rodrigospimentacwb/lava_louca_110v_esp_32/caixa/desenhos/previa_base.png

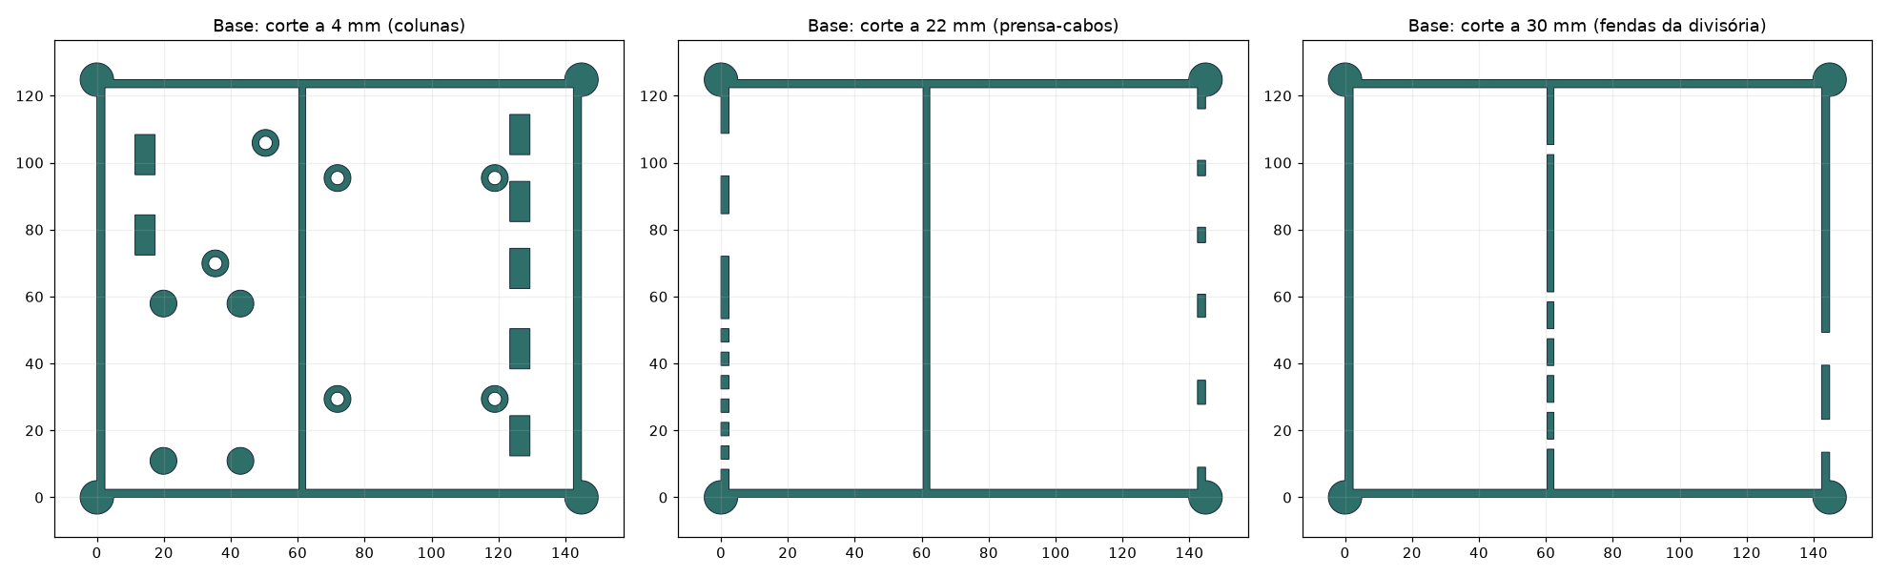
caixa/desenhos/previa_base.png
