rodrigospimentacwb/lava_louca_110v_esp_32/caixa/desenhos/previa_tampa.png

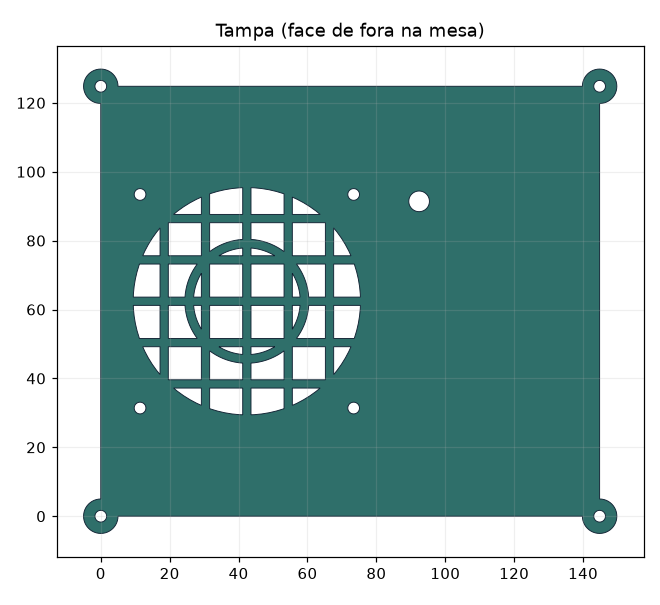
caixa/desenhos/previa_tampa.png
