rodrigospimentacwb/lava_louca_110v_esp_32/caixa/desenhos/render_tampa.png

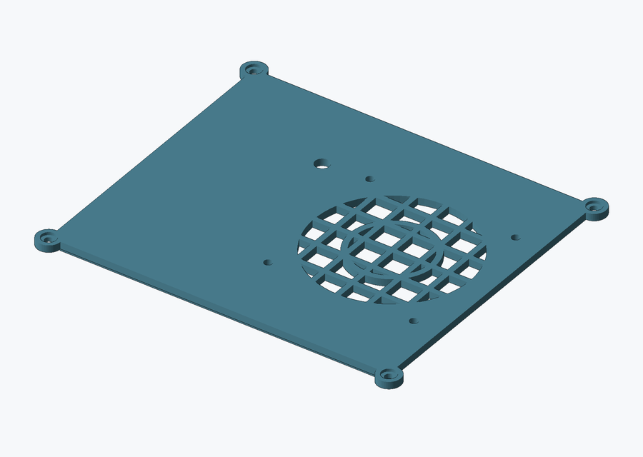
caixa/desenhos/render_tampa.png
