rodrigospimentacwb/lava_louca_110v_esp_32/caixa/desenhos/caixa_base.stl

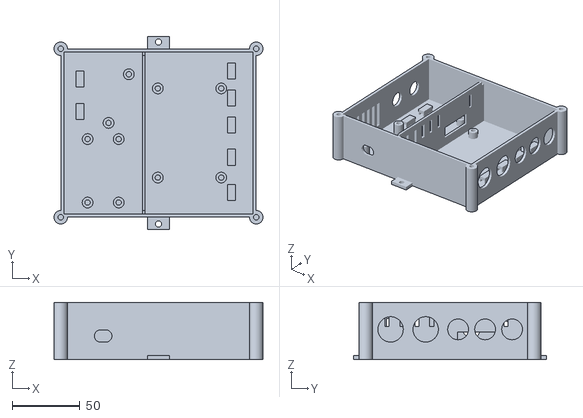
[picture p13: CAD file, 2026-10-19]
caixa/desenhos/caixa_base.stl
154.8 x 142.8 x 42.4
