rodrigospimentacwb/lava_louca_110v_esp_32/caixa/desenhos/caixa_bambu.3mf

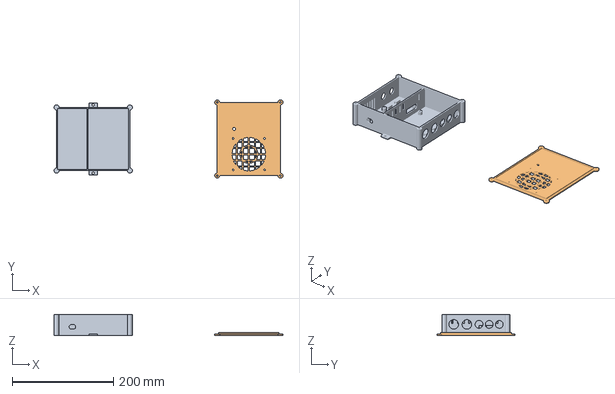
[picture p14: CAD file, 2026-10-19]
caixa/desenhos/caixa_bambu.3mf
452.0 x 154.8 x 42.4 mm
base
tampa
