rodrigospimentacwb/lava_louca_110v_esp_32/caixa/desenhos/caixa_lava_loucas.3mf

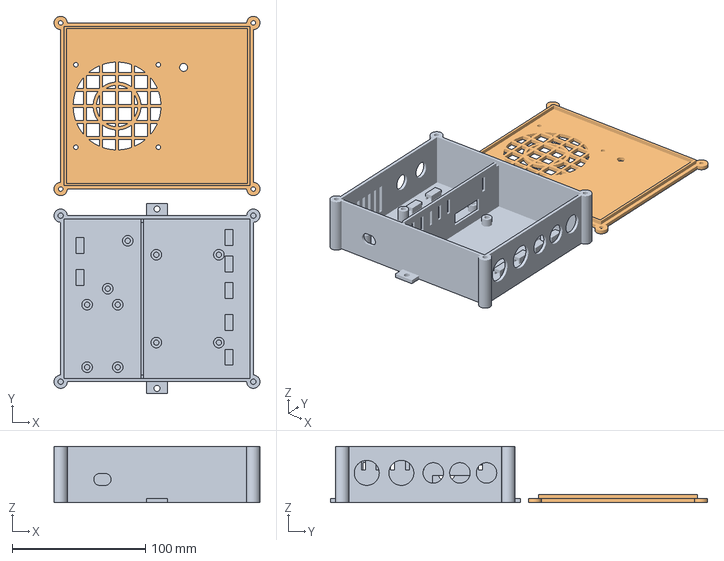
[picture p15: CAD file, 2026-10-19]
caixa/desenhos/caixa_lava_loucas.3mf
154.8 x 283.6 x 42.4 mm
base
tampa
