rodrigospimentacwb/lava_louca_110v_esp_32/caixa/desenhos/gabarito_reles.stl

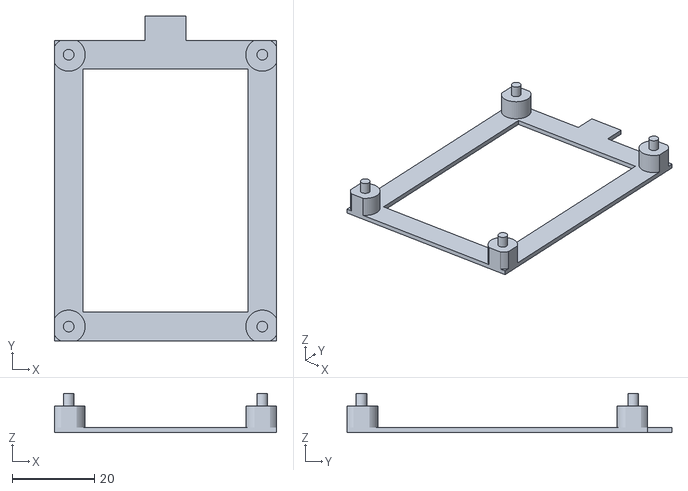
[picture p16: CAD file, 2026-10-19]
caixa/desenhos/gabarito_reles.stl
54.0 x 78.9 x 9.50
