rodrigospimentacwb/lava_louca_110v_esp_32/caixa/desenhos/gabaritos.3mf

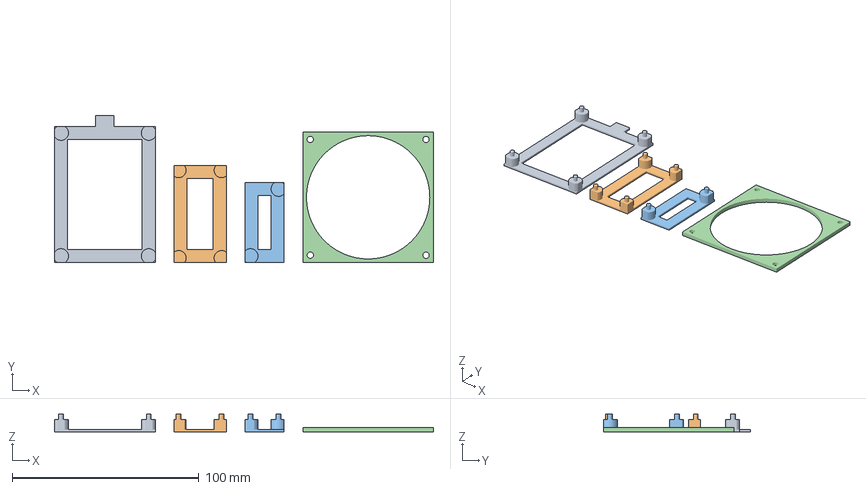
[picture p17: CAD file, 2026-10-19]
caixa/desenhos/gabaritos.3mf
203.0 x 78.9 x 9.50 mm
reles
esp32
lm2596
fan
