rodrigospimentacwb/lava_louca_110v_esp_32/caixa/desenhos/caixa_tampa.stl

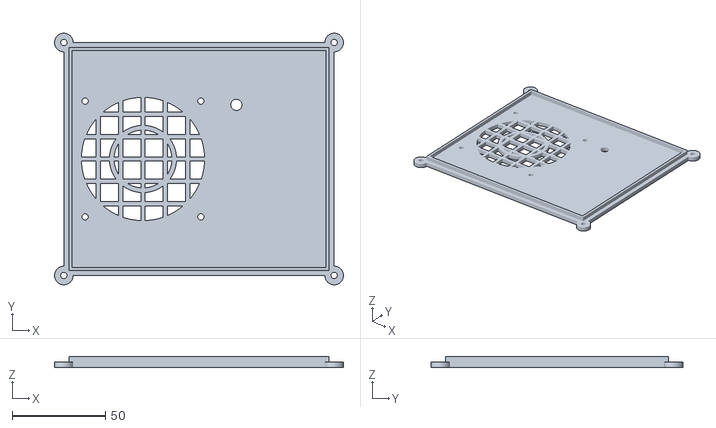
[picture p18: CAD file, 2026-10-18]
caixa/desenhos/caixa_tampa.stl
154.8 x 134.8 x 5.99
