rodrigospimentacwb/lava_louca_110v_esp_32/(list of files, cad)

Other CAD files:
caixa/desenhos/gabaritos.stl
