rodrigospimentacwb/lava_louca_110v_esp_32/LavaLoucas/src/web/network.h

// network.h  -  Wi-Fi e mDNS.
//   - Rede própria da placa (AP), sempre ligada: http://192.168.4.1
//   - Rede de casa, se WIFI_SSID estiver preenchido no secrets.h: http://lavaloucas.local
#pragma once

#include <Arduino.h>

void setupNetwork();
String networkAddresses();  // "192.168.0.50 / 192.168.4.1" (casa / AP)
bool updateEnabled();                     // OTA_PASS definida no secrets.h (8+ caracteres)
bool updatePasswordOk(const String& typed);  // senha de atualização certa
