rodrigospimentacwb/lava_louca_110v_esp_32/LavaLoucas/src/web/web_server.h

// web_server.h  -  servidor HTTP: a página (page.h) e a API JSON que ela usa.
//
//   Aba Principal                    Aba Debug/Admin
//   GET  /api/status                 GET  /api/debug
//   POST /api/cycle?cmd=start|stop   POST /api/relay?i=0..3&on=0|1
//                                    POST /api/water?v=0|1
//                                    GET/POST /api/config
//                                    POST /api/config/defaults
//                                    POST /api/log/clear
//                                    POST /api/restart
//                                    POST /api/update (arquivo .bin + X-Senha)
#pragma once

void setupWebServer();     // no setup(), depois do Wi-Fi
void handleWebClients();   // a cada volta do loop()
