rodrigospimentacwb/lava_louca_110v_esp_32/(commit log)

2026-10-18 Firmware ESP32, página web e documentação (#1)
    - Firmware para ESP32 DevKit V1 que substitui o timer da lava-louças:
    ciclo por etapas, travas de segurança (porta, Klixon, água, termostato,
    solenoide x drenagem) e módulo de 4 relés ativo em LOW.
    - Página web offline com abas Principal e Debug e admin, e API JSON.
    - README, LIGACAO.md (ligação, alimentação do módulo pelo VIN, ordem de
    testes) e regras em .claude/rules para quem usar o Claude Code.
2026-10-18 Protege a API contra pedidos de outros sites e trava a resistência com água marcada à mão (#2)
    - Ações (POST) exigem o cabeçalho X-Lava: 1, que a página manda (bloqueia CSRF).
    - Rotas /api exigem o Host da placa: IP de casa, IP do AP ou lavaloucas.local
    (bloqueia DNS rebinding).
    - "Marcar com água" na página só informa: a resistência exige água que entrou
    pelo solenoide (waterFromValve).
    - Documentação e regras atualizadas.
2026-10-18 README: segurança detalhada, andamento dos testes e dica de alimentação (#3)
2026-10-18 Caixa impressa: base, tampa com fan e gabaritos de furação (#4)
    Desenho paramétrico em Python (manifold3d + trimesh) para a Bambu A1:
    divisória entre 110 V e baixa tensão, furos para prensa-cabos com
    âncoras de abraçadeira, fan de 70 mm na tampa, insertos M3 na tampa e
    M2 nas placas. Furação da ESP32, dos relés e do fan conferida com os
    gabaritos; a do LM2596 ainda é estimada.
    [caixa_base.stl, caixa_lava_loucas.3mf, caixa_tampa.stl, gabaritos.3mf, gabaritos.stl]
2026-10-18 Caixa: projeto do Bambu, imagens 3D e lista de materiais no README (#5)
    * Caixa: projeto do Bambu Studio com as duas placas e as configurações
    * README: caixa com imagens 3D e lista de materiais; testes de bancada concluídos
    - Seção "A caixa" com imagens da base e da caixa montada e a lista de materiais.
    - caixa/render.py gera as imagens (rasterizador simples com z-buffer).
    - Andamento: resistência com água só marcada à mão e encher × drenar testados.
    ---------
    [caixa_bambu.3mf]
2026-10-19 Caixa: placas em M3, colunas longe das paredes e furação real dos relés (#6)
    * Caixa: colunas das placas em M3, longe das paredes, e furação real dos relés
    - Colunas da ESP32, dos relés e do LM2596 com inserto M3 × 4 e parafuso M3 × 6
    (colunas de 8 mm). O dono não tinha parafusos M2.
    - Colunas afastadas das paredes e da divisória (ESP no meio, LM2596 atrás
    dela, relés a ~9 mm da divisória): perto da parede o ferro derretia a lateral.
    - Furos dos relés medidos com paquímetro na placa: 3,5 mm das bordas,
    47 × 66 entre centros. As correções feitas pelo gabarito estavam erradas.
    - Furo da USB maior (13 × 9) porque a ESP ficou a 6 mm da parede.
    - Gabarito com pinos de 2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
    [caixa_bambu.3mf, caixa_base.stl, caixa_lava_loucas.3mf, gabarito_reles.stl, gabaritos.3mf, gabaritos.stl]
2026-10-27 Klixon em série com a resistência e sensores NA/NF reais (#7)
    * Klixon em série com a resistência e sensores com o tipo real (NA/NF)
    Medido na máquina: o Klixon preso na resistência é NF (fechado frio) e o
    termostato da cuba é NA (aberto frio), o contrário do que o firmware supunha.
    - tankHot() passa a ser LOW (termostato fechou) e klixonTripped() HIGH (abriu)
    - Klixon vai em série com a resistência no 110 V e corta sozinho;
    KLIXON_ON_ESP = false deixa o D21 livre (sem isso, D21 solto = disparado)
    - Com KLIXON_ON_ESP = true, Klixon disparado só desliga a resistência até a
    próxima etapa; o ciclo segue. Acabou a falha que cancelava tudo e o
    "Limpar falha" (/api/reset)
    -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
    [LavaLoucas.ino, config.h, cycle.cpp, cycle.h, network.cpp, network.h]
